tmolteno/TART-3/hardware/lna/img/lna3d.png

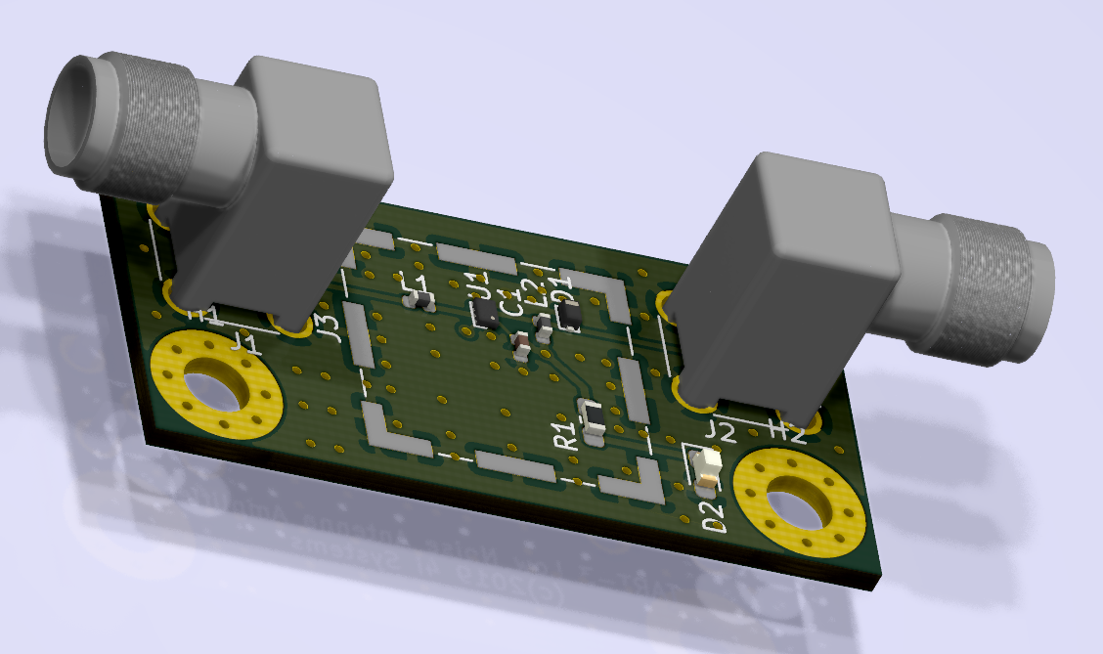
hardware/lna/img/lna3d.png
