tmolteno/TART-3/hardware/lna/img/20190927_lnaAssembled.jpg

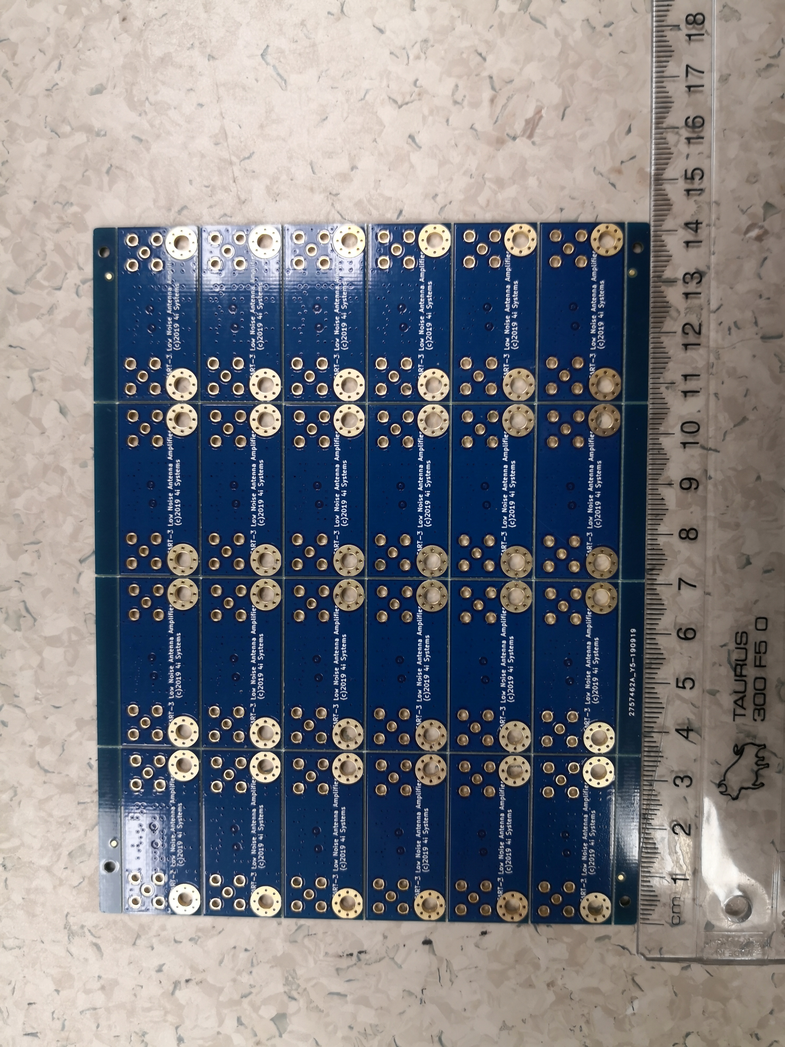
hardware/lna/img/20190927_lnaAssembled.jpg
