tmolteno/TART-3/README.md

# TART-3
The TART radio telescope, Version 3.

TART-3/hardware contains the physical design files.

TART-3/hardware/lna is the design for the seperate low noise front end required when using passive antennas.
