tmolteno/TART-3/hardware/lna/README.md

# TART-3 Low Noise Amplifier

The TART-3 LNA connects the antenna to the radio receiver. 

It is powered by the radio receiver through the coax. The design goal is to get up to 10m of cable.
