tmolteno/TART-3/array/disko_array_opt/README.md

## Array Optimization using the Singular Values of the telescope operator

Author: Tim Molteno

See the jupyter notebook for details.

TODO: 

* Add the ability to start from a JSON file.

The following array reached 16.1:

        Arm 0: [0.224 0.344 0.787 1.292 1.600 1.928 2.864 3.121]
        Arm 120: [0.229 0.897 1.324 2.250 2.585 2.712 3.544 4.174]
        Arm 240: [0.094 0.106 1.001 1.158 1.273 1.575 2.148 3.008]
