tmolteno/TART-3/hardware/lna/img/20191018_lnaScreen.jpg

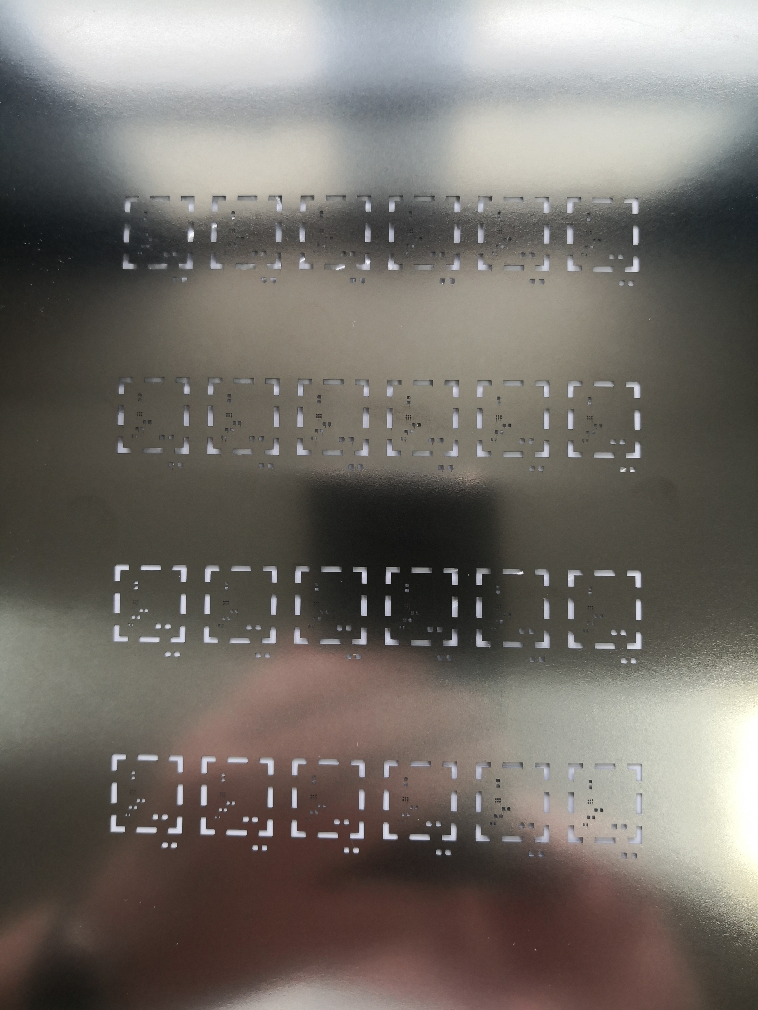
hardware/lna/img/20191018_lnaScreen.jpg
