tmolteno/TART-3/hardware/lna/lna.png

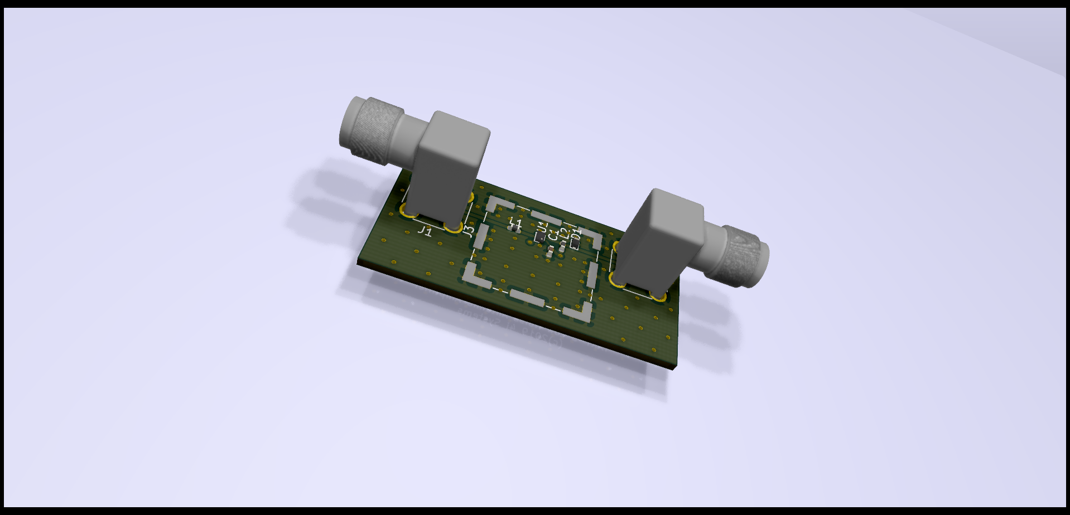
hardware/lna/lna.png
