tmolteno/TART-3/hardware/radio_module/img/radio_module3dBottom.png

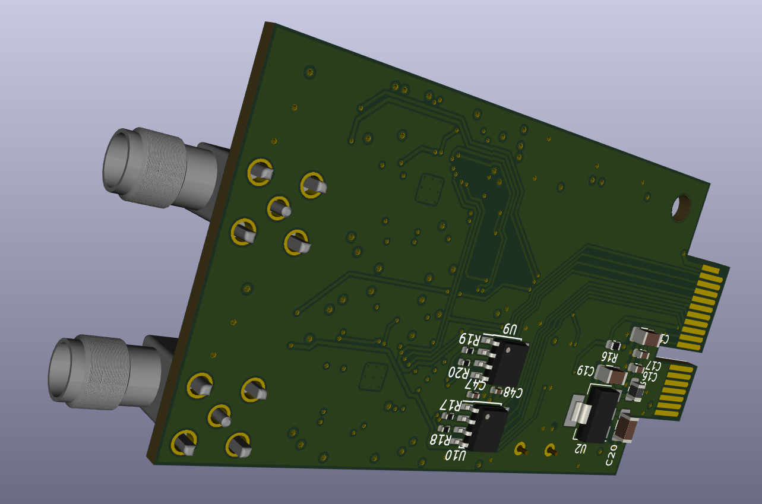
hardware/radio_module/img/radio_module3dBottom.png
