tmolteno/TART-3/hardware/radio_module/img/rf_power-RF Power system.pdf

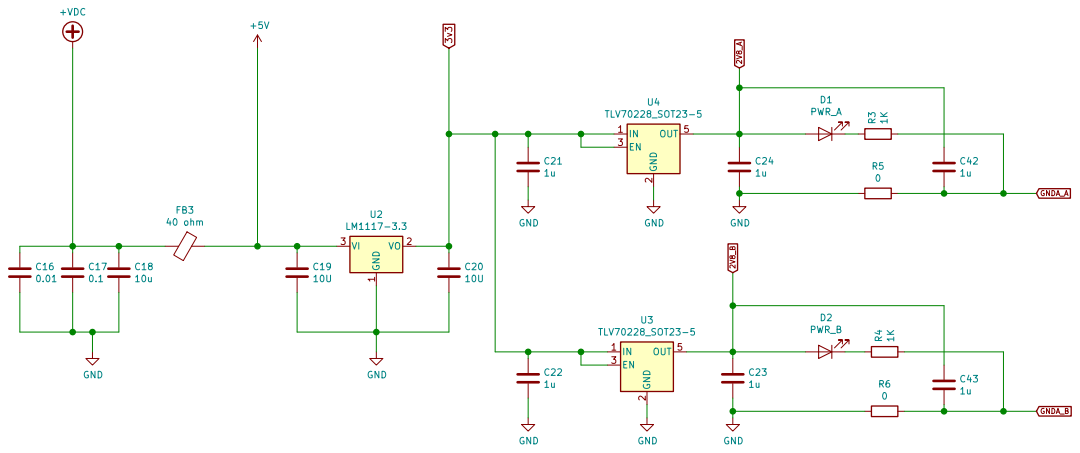
[picture p7: page 1]

Sheet: /RF Power system/ C18
0.1 GND
