tmolteno/TART-3/hardware/lna/img/lna-B_Cu.pdf

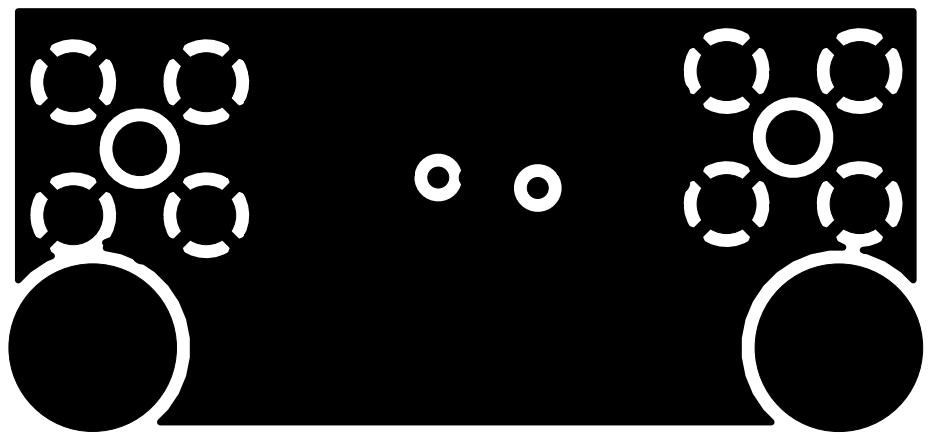
[picture p8: page 1]
