tmolteno/TART-3/hardware/lna/img/lna-F_Cu.pdf

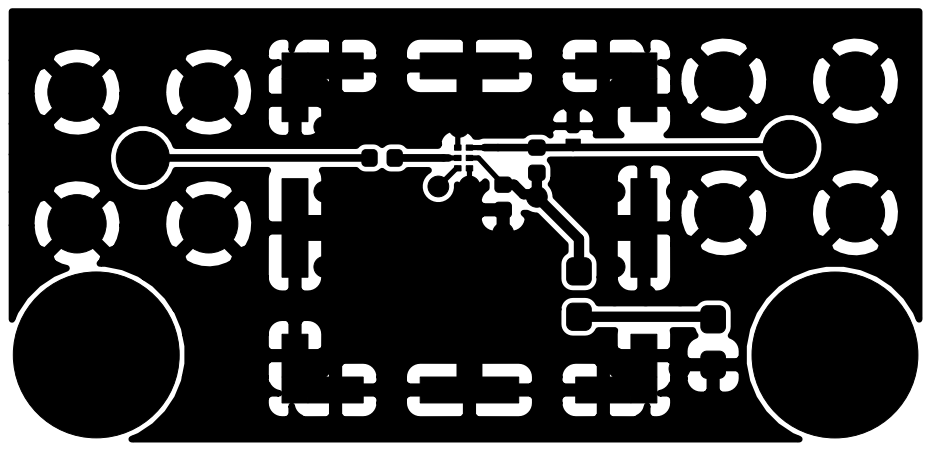
[picture p9: page 1]
