tmolteno/TART-3/hardware/lna/img/lna-F_SilkS.pdf

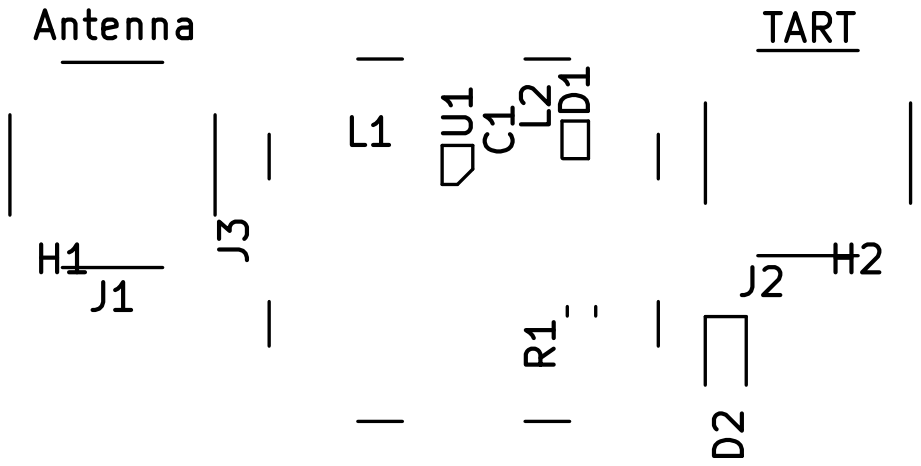
[picture p10: page 1]
