tmolteno/TART-3/hardware/lna/img/lna-In2_Cu.pdf

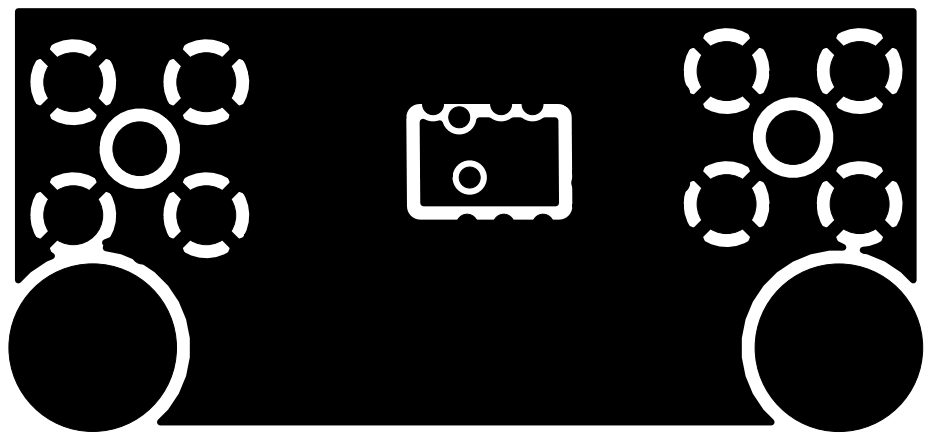
[picture p11: page 1]
