tmolteno/TART-3/hardware/radio_module/img/interface-Interface_A.pdf

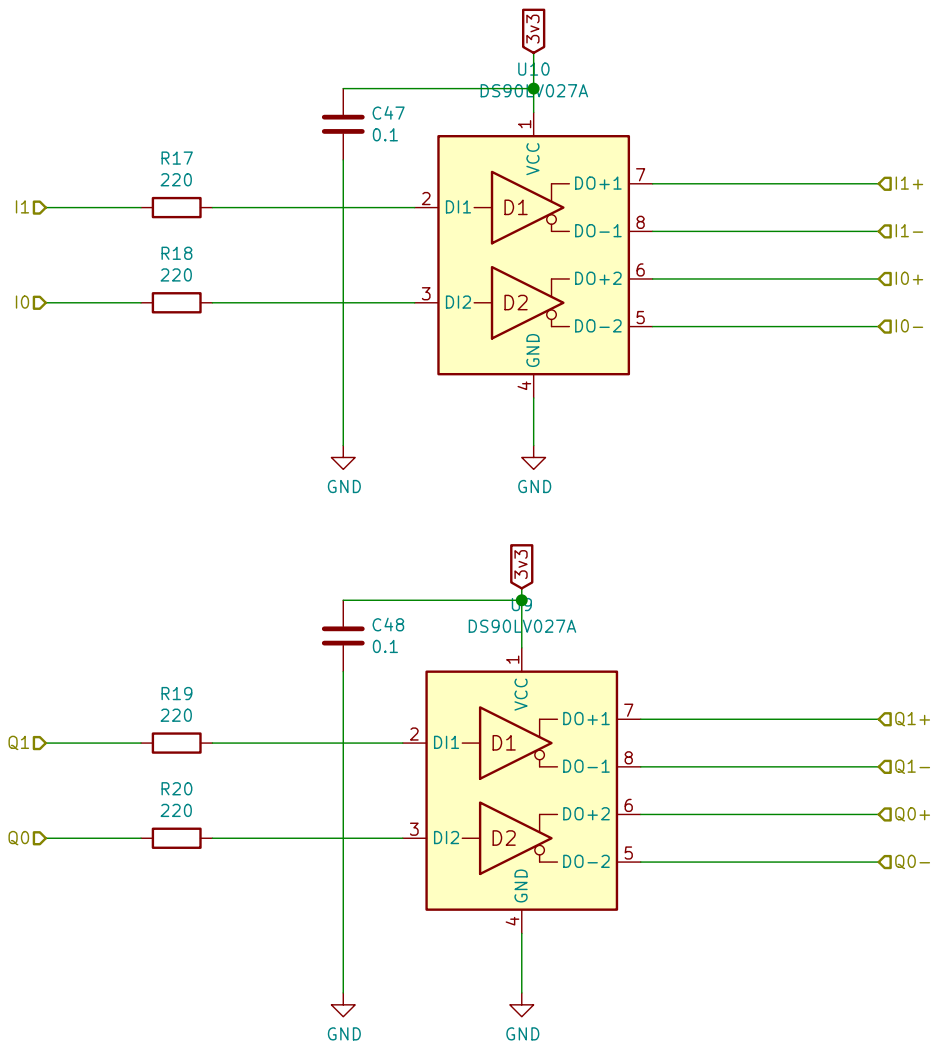
[picture p12: page 1]
