tmolteno/TART-3/hardware/radio_module/img/radio_module.pdf

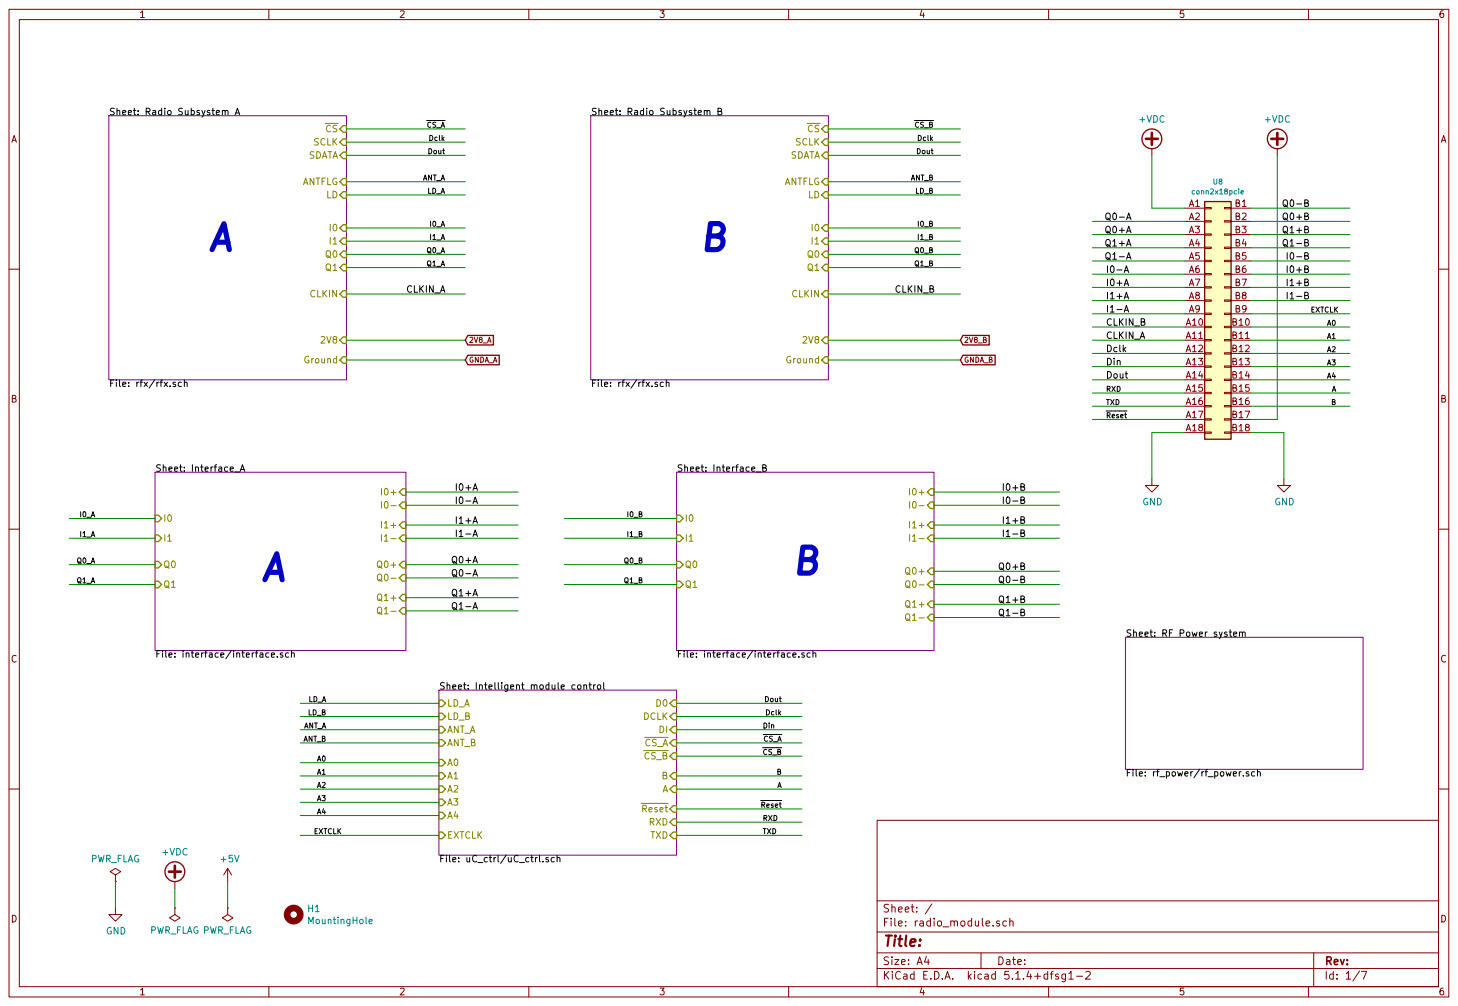
[picture p13: page 1]

File: interface/interface.sch
