tmolteno/TART-3/hardware/radio_module/img/rfx-Radio Subsystem A.pdf

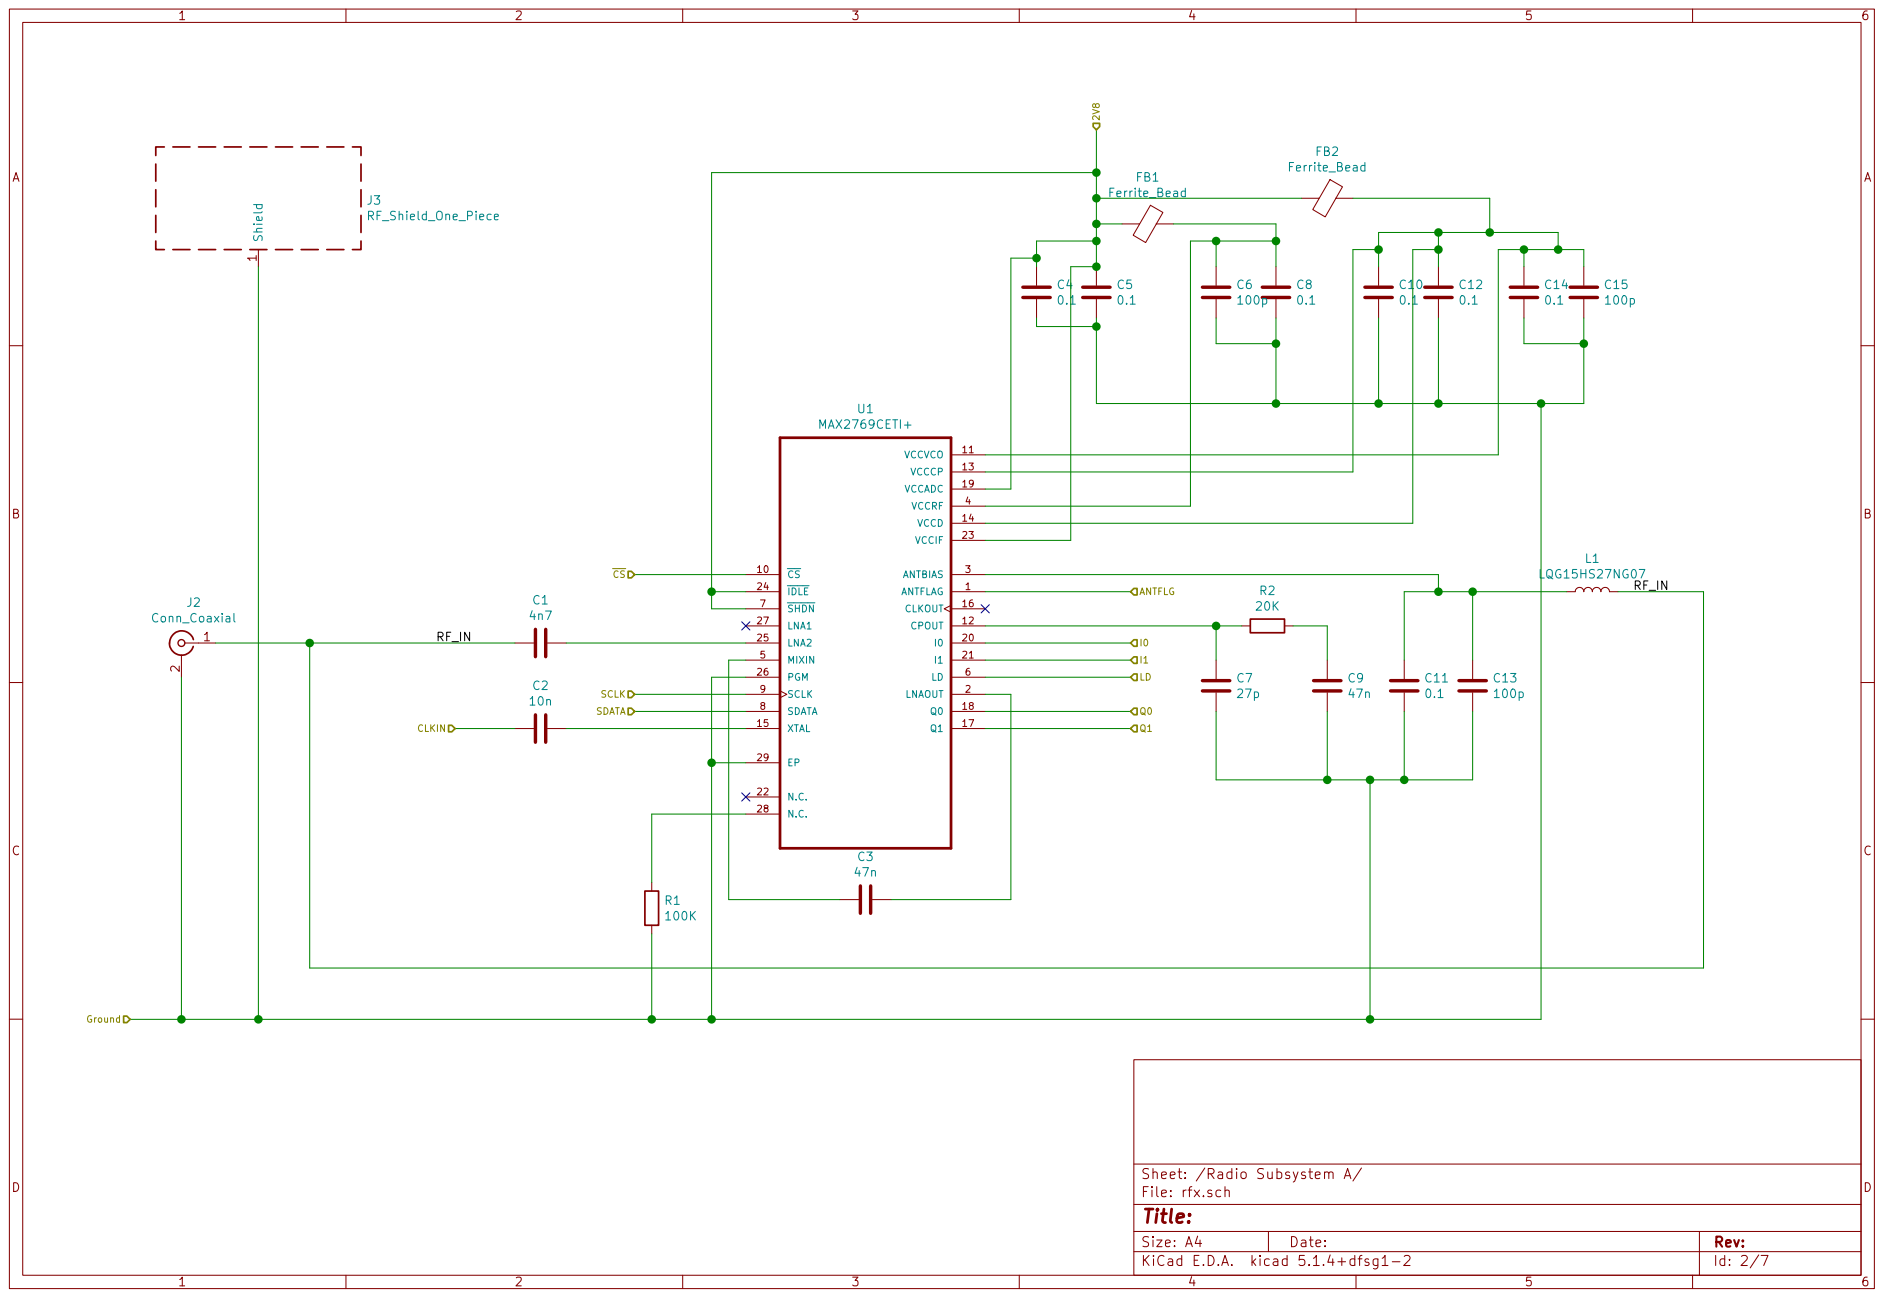
[picture p14: page 1]

Id: 2/7 Title: File: rfx.sch Sheet: /Radio Subsystem A/
