tmolteno/TART-3/hardware/radio_module/img/uC_ctrl-Intelligent module control.pdf

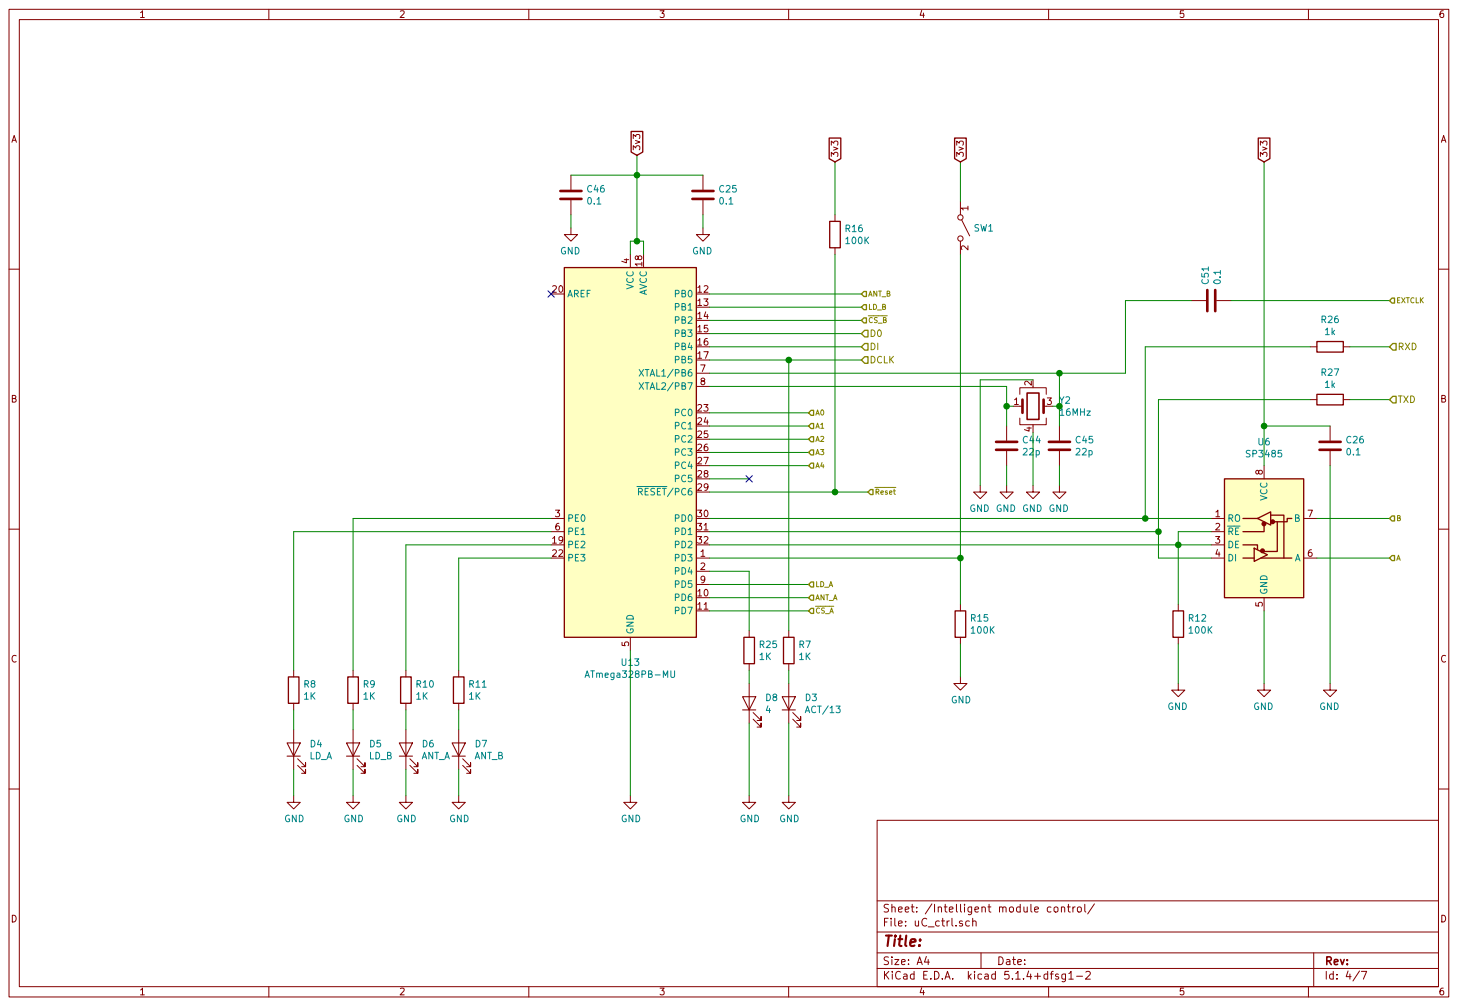
[picture p15: page 1]

Sheet: /Intelligent module control/
File: uC_ctrl.sch
Id: 4/7 Title:
