tmolteno/TART-3/hardware/test/test_fpga_module/test_fpga_module.kicad_pcb

## KiCad design hardware/test/test_fpga_module/test_fpga_module.kicad_pcb (2020-03-13)

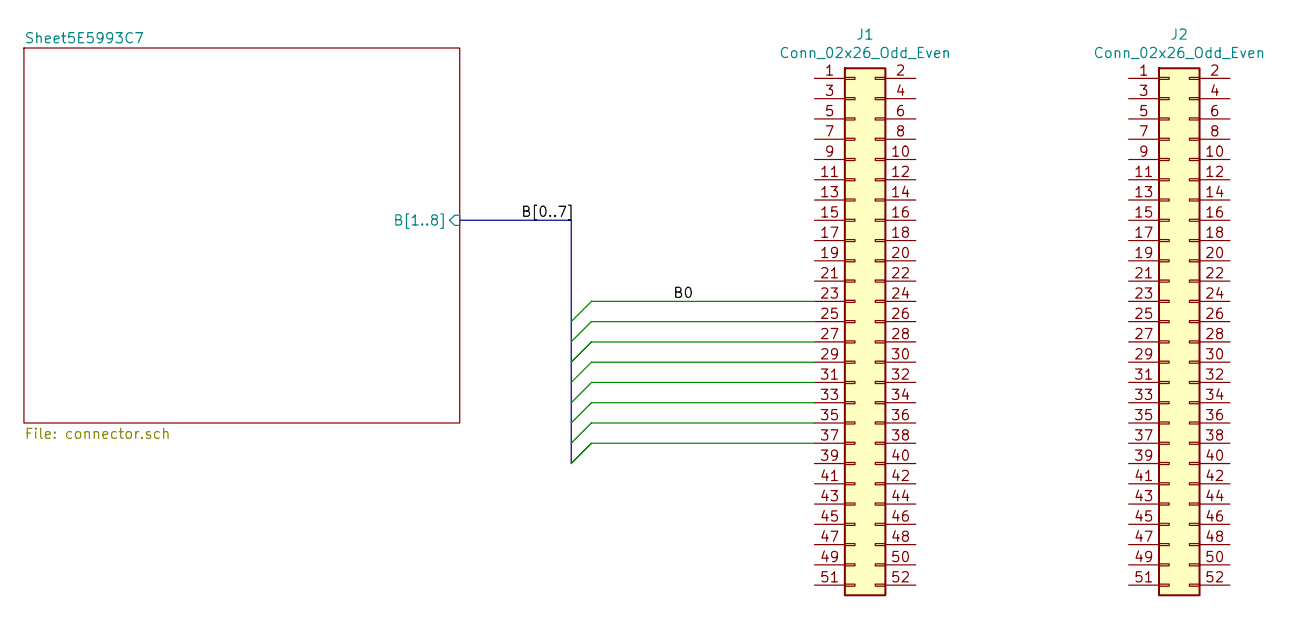
[picture p30: schematic test_fpga_module.sch]

Parts:
J1, J2: Conn_02x26_Odd_Even; Samtec_LSHM-150-xx.x-x-DV-S_2x50-1SH_P0.50mm_Vertical

Connections:
/A1: J1.37; also elsewhere on the board
/A2: J1.35; also elsewhere on the board
/A3: J1.33; also elsewhere on the board
/A4: J1.31; also elsewhere on the board
/A5: J1.29; also elsewhere on the board
/A6: J1.27; also elsewhere on the board
/A7: J1.25; also elsewhere on the board
/A8: J1.23; also elsewhere on the board

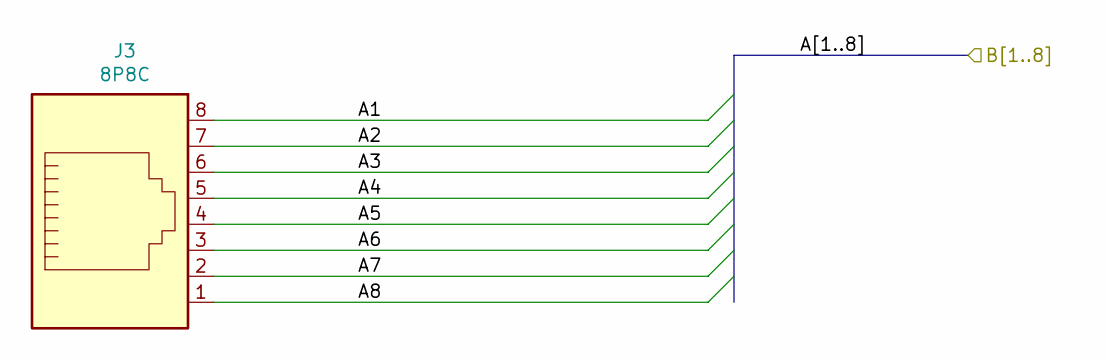
[picture p31: schematic connector.sch]

Parts:
J3: 8P8C; RJ45_Amphenol_54602-x08_Horizontal

Connections:
/A1: J3.8; also elsewhere on the board
/A2: J3.7; also elsewhere on the board
/A3: J3.6; also elsewhere on the board
/A4: J3.5; also elsewhere on the board
/A5: J3.4; also elsewhere on the board
/A6: J3.3; also elsewhere on the board
/A7: J3.2; also elsewhere on the board
/A8: J3.1; also elsewhere on the board

Board: 2 copper layers, 3 parts (0 on the bottom side), 8 nets, no tracks yet.
