tmolteno/TART-3/hardware/radio_dev_board/radioDev.kicad_pcb

## KiCad design hardware/radio_dev_board/radioDev.kicad_pcb (2020-02-21)

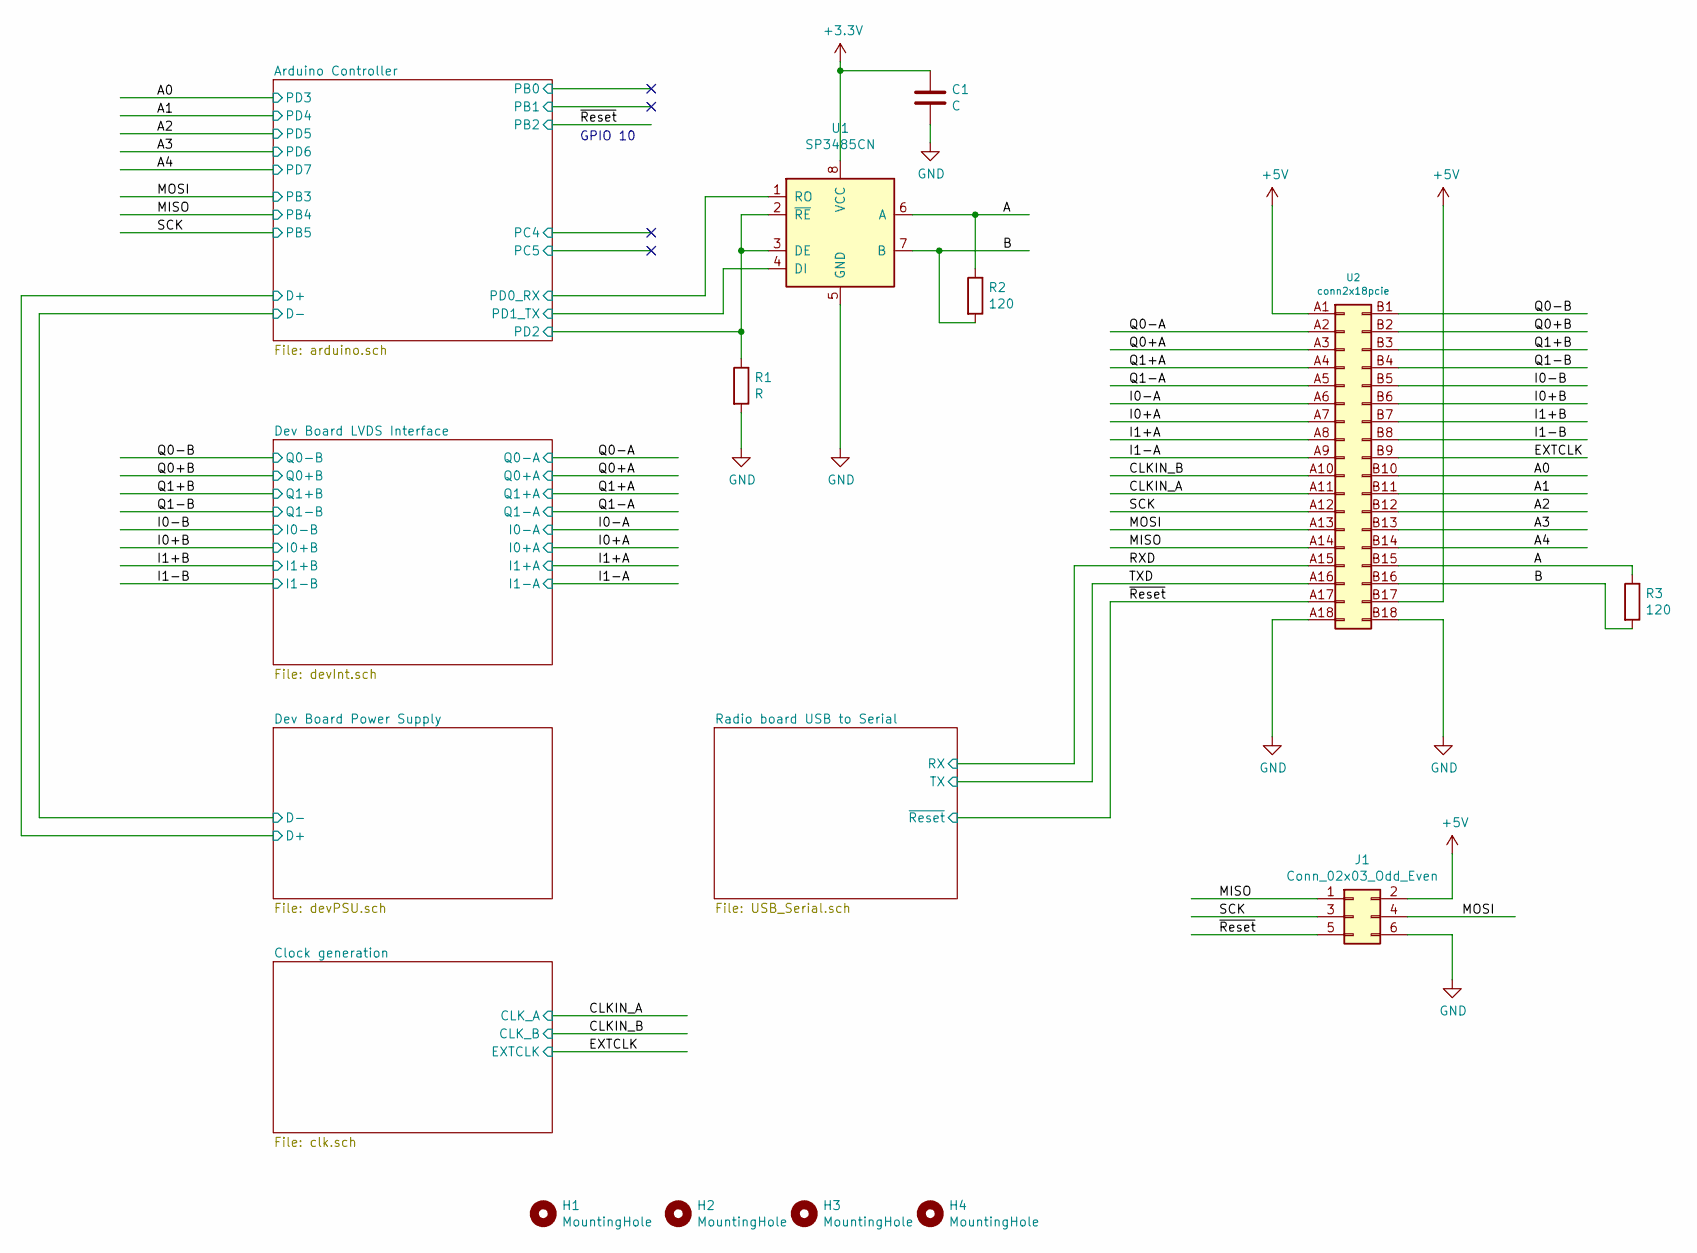
[picture p32: schematic radioDev.sch]

Parts:
C1: C; C_0603_1608Metric_Pad1.05x0.95mm_HandSolder
H1, H2, H3, H4: MountingHole; MountingHole_3.2mm_M3_DIN965
J1: Conn_02x03_Odd_Even; PinHeader_2x03_P2.54mm_Vertical
R1: R; R_0603_1608Metric_Pad1.05x0.95mm_HandSolder
R2, R3: 120; R_0603_1608Metric_Pad1.05x0.95mm_HandSolder
U1: SP3485CN; SOIC-8_3.9x4.9mm_P1.27mm
U2: conn2x18pcie; MOLEX_0877159002

Connections:
+5V: J1.2, U2.A1, U2.B17; also elsewhere on the board
/A: R2.1, R3.1, U1.6 (A), U2.B15
/A0: U2.B10; also elsewhere on the board
/A1: U2.B11; also elsewhere on the board
/A2: U2.B12; also elsewhere on the board
/A3: U2.B13; also elsewhere on the board
/A4: U2.B14; also elsewhere on the board
/Arduino Controller/PD0_RX: U1.1 (RO); also elsewhere on the board
/Arduino Controller/PD1_TX: U1.4 (DI); also elsewhere on the board
/Arduino Controller/PD2: R1.1, U1.2 (~RE~), U1.3 (DE); also elsewhere on the board
/B: R2.2, R3.2, U1.7 (B), U2.B16
/CLKIN_A: U2.A10, U2.A11, U2.B9; also elsewhere on the board
/I0+A: U2.A7; also elsewhere on the board
/I0+B: U2.B6; also elsewhere on the board
/I0-A: U2.A6; also elsewhere on the board
/I0-B: U2.B5; also elsewhere on the board
/I1+A: U2.A8; also elsewhere on the board
/I1+B: U2.B7; also elsewhere on the board
/I1-A: U2.A9; also elsewhere on the board
/I1-B: U2.B8; also elsewhere on the board
/MISO: J1.1, U2.A14; also elsewhere on the board
/MOSI: J1.4, U2.A13; also elsewhere on the board
/Q0+A: U2.A3; also elsewhere on the board
/Q0+B: U2.B2; also elsewhere on the board
/Q0-A: U2.A2; also elsewhere on the board
/Q0-B: U2.B1; also elsewhere on the board
/Q1+A: U2.A4; also elsewhere on the board
/Q1+B: U2.B3; also elsewhere on the board
/Q1-A: U2.A5; also elsewhere on the board
/Q1-B: U2.B4; also elsewhere on the board
/RXD: U2.A15; also elsewhere on the board
/SCK: J1.3, U2.A12; also elsewhere on the board
/TXD: U2.A16; also elsewhere on the board
/~Reset: J1.5, U2.A17; also elsewhere on the board
GND: C1.2, J1.6, R1.2, U1.5 (GND), U2.A18, U2.B18; also elsewhere on the board

Notes on the sheet:
GPIO 10
