tmolteno/TART-3/hardware/radio_dev_board/radioDev.kicad_pcb

## KiCad design hardware/radio_dev_board/radioDev.kicad_pcb (continued)

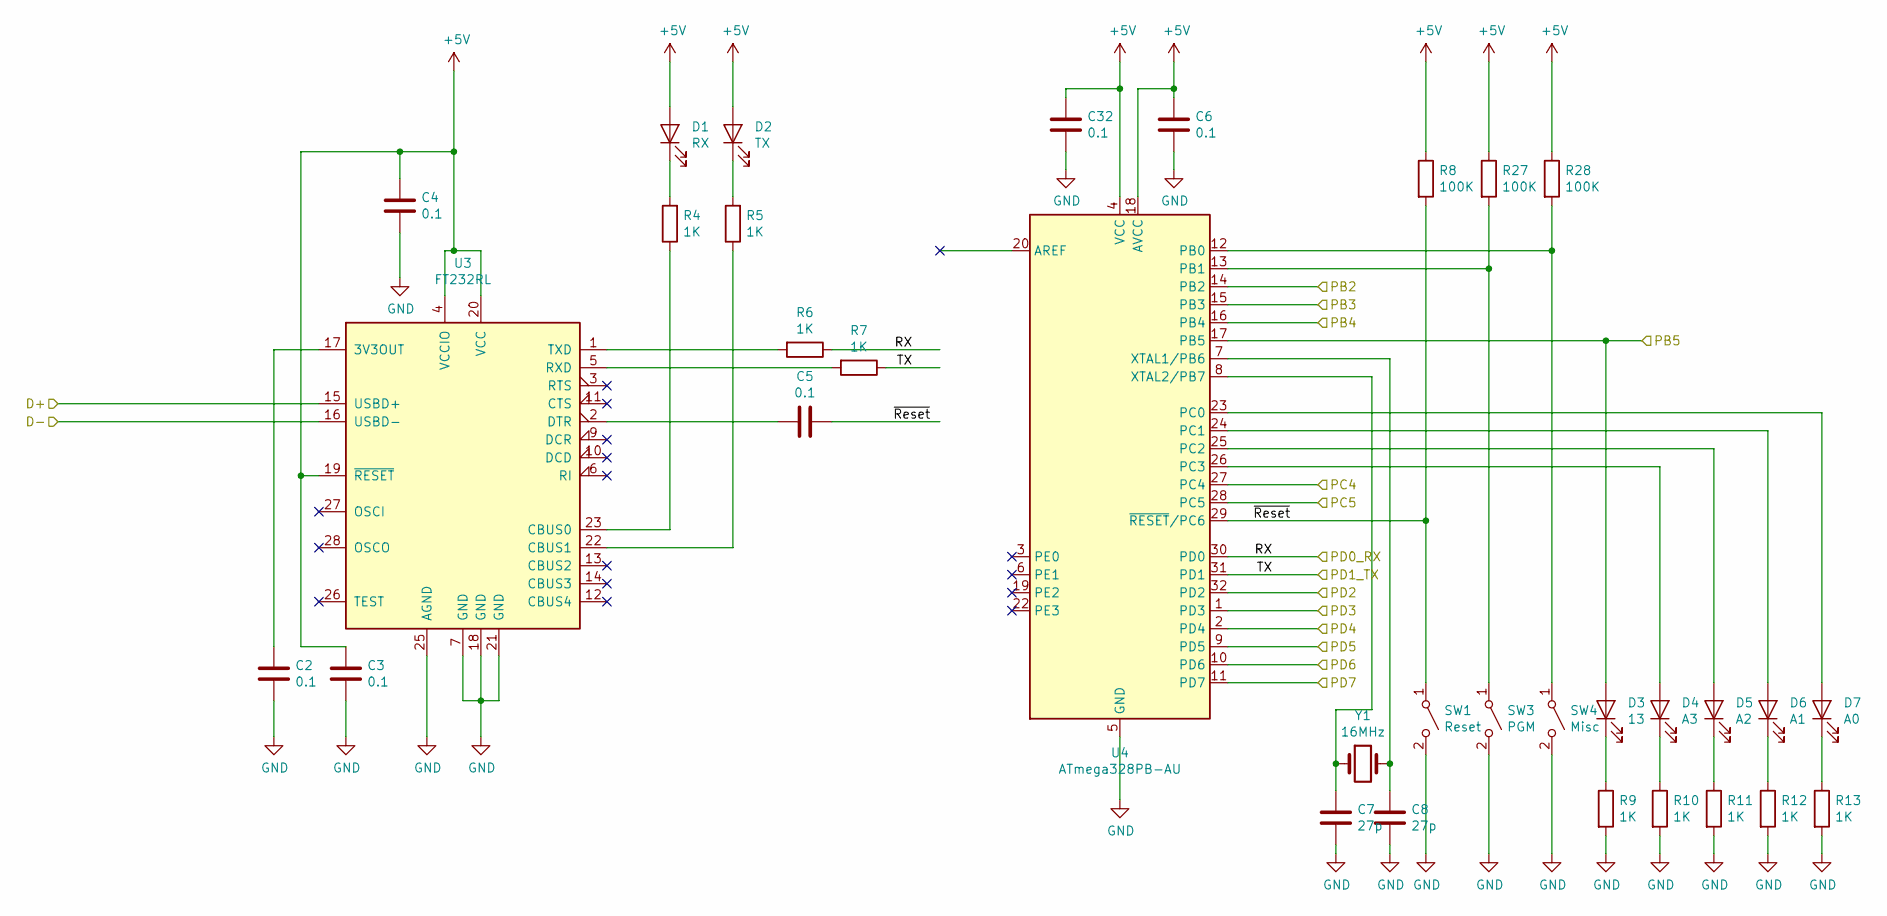
[picture p33: schematic arduino.sch]

Parts:
C2, C3, C4, C5, C6, C32: 0.1; C_0603_1608Metric_Pad1.05x0.95mm_HandSolder
C7, C8: 27p; C_0603_1608Metric_Pad1.05x0.95mm_HandSolder
D1: RX; LED_0603_1608Metric_Pad1.05x0.95mm_HandSolder
D2: TX; LED_0603_1608Metric_Pad1.05x0.95mm_HandSolder
D3: 13; LED_0603_1608Metric_Pad1.05x0.95mm_HandSolder
D4: A3; LED_0603_1608Metric_Pad1.05x0.95mm_HandSolder
D5: A2; LED_0603_1608Metric_Pad1.05x0.95mm_HandSolder
D6: A1; LED_0603_1608Metric_Pad1.05x0.95mm_HandSolder
D7: A0; LED_0603_1608Metric_Pad1.05x0.95mm_HandSolder
R4, R5, R6, R7, R9, R10, R11, R12, R13: 1K; R_0603_1608Metric_Pad1.05x0.95mm_HandSolder
R8, R27, R28: 100K; R_0603_1608Metric_Pad1.05x0.95mm_HandSolder
SW1: Reset; SW_SPST_PTS645
SW3: PGM; SW_SPST_PTS645
SW4: Misc; SW_SPST_PTS645
U3: FT232RL; SSOP-28_5.3x10.2mm_P0.65mm
U4: ATmega328PB-AU; TQFP-32_7x7mm_P0.8mm
Y1: 16MHz; Crystal_HC49-4H_Vertical

Connections:
+5V: C3.1, C4.1, C6.1, C32.1, D1.2 (A), D2.2 (A), R8.1, R27.1, R28.1, U3.4 (VCCIO), U3.19 (~RESET~), U3.20 (VCC), U4.4 (VCC), U4.18 (AVCC); also elsewhere on the board
/A0: U4.1 (PD3); also elsewhere on the board
/A1: U4.2 (PD4); also elsewhere on the board
/A2: U4.9 (PD5); also elsewhere on the board
/A3: U4.10 (PD6); also elsewhere on the board
/A4: U4.11 (PD7); also elsewhere on the board
/Arduino Controller/D+: U3.15 (USBD+); also elsewhere on the board
/Arduino Controller/D-: U3.16 (USBD-); also elsewhere on the board
/Arduino Controller/PD0_RX: R6.1, U4.30 (PD0); also elsewhere on the board
/Arduino Controller/PD1_TX: R7.1, U4.31 (PD1); also elsewhere on the board
/Arduino Controller/PD2: U4.32 (PD2); also elsewhere on the board
/Arduino Controller/~Reset: C5.1, R8.2, SW1.1 (A), U4.29 (~RESET~/PC6)
/MISO: U4.16 (PB4); also elsewhere on the board
/MOSI: U4.15 (PB3); also elsewhere on the board
/SCK: D3.2 (A), U4.17 (PB5); also elsewhere on the board
/~Reset: U4.14 (PB2); also elsewhere on the board
GND: C2.2, C3.2, C4.2, C6.2, C7.2, C8.2, C32.2, R9.2, R10.2, R11.2, R12.2, R13.2, SW1.2 (B), SW3.2 (B), SW4.2 (B), U3.7 (GND), U3.18 (GND), U3.21 (GND), U3.25 (AGND), U4.5 (GND), U4.21 (GND); also elsewhere on the board
unnamed: C2.1, U3.17 (3V3OUT)
unnamed: C5.2, U3.2 (DTR)
unnamed: C7.1, U4.8 (XTAL2/PB7), Y1.1
unnamed: C8.1, U4.7 (XTAL1/PB6), Y1.2
unnamed: D1.1 (K), R4.2
unnamed: D2.1 (K), R5.2
unnamed: D3.1 (K), R9.1
unnamed: D4.1 (K), R10.1
unnamed: D4.2 (A), U4.26 (PC3)
unnamed: D5.1 (K), R11.1
unnamed: D5.2 (A), U4.25 (PC2)
unnamed: D6.1 (K), R12.1
unnamed: D6.2 (A), U4.24 (PC1)
unnamed: D7.1 (K), R13.1
unnamed: D7.2 (A), U4.23 (PC0)
unnamed: R4.1, U3.23 (CBUS0)
unnamed: R5.1, U3.22 (CBUS1)
unnamed: R6.2, U3.1 (TXD)
unnamed: R7.2, U3.5 (RXD)
unnamed: R27.2, SW3.1 (A), U4.13 (PB1)
unnamed: R28.2, SW4.1 (A), U4.12 (PB0)

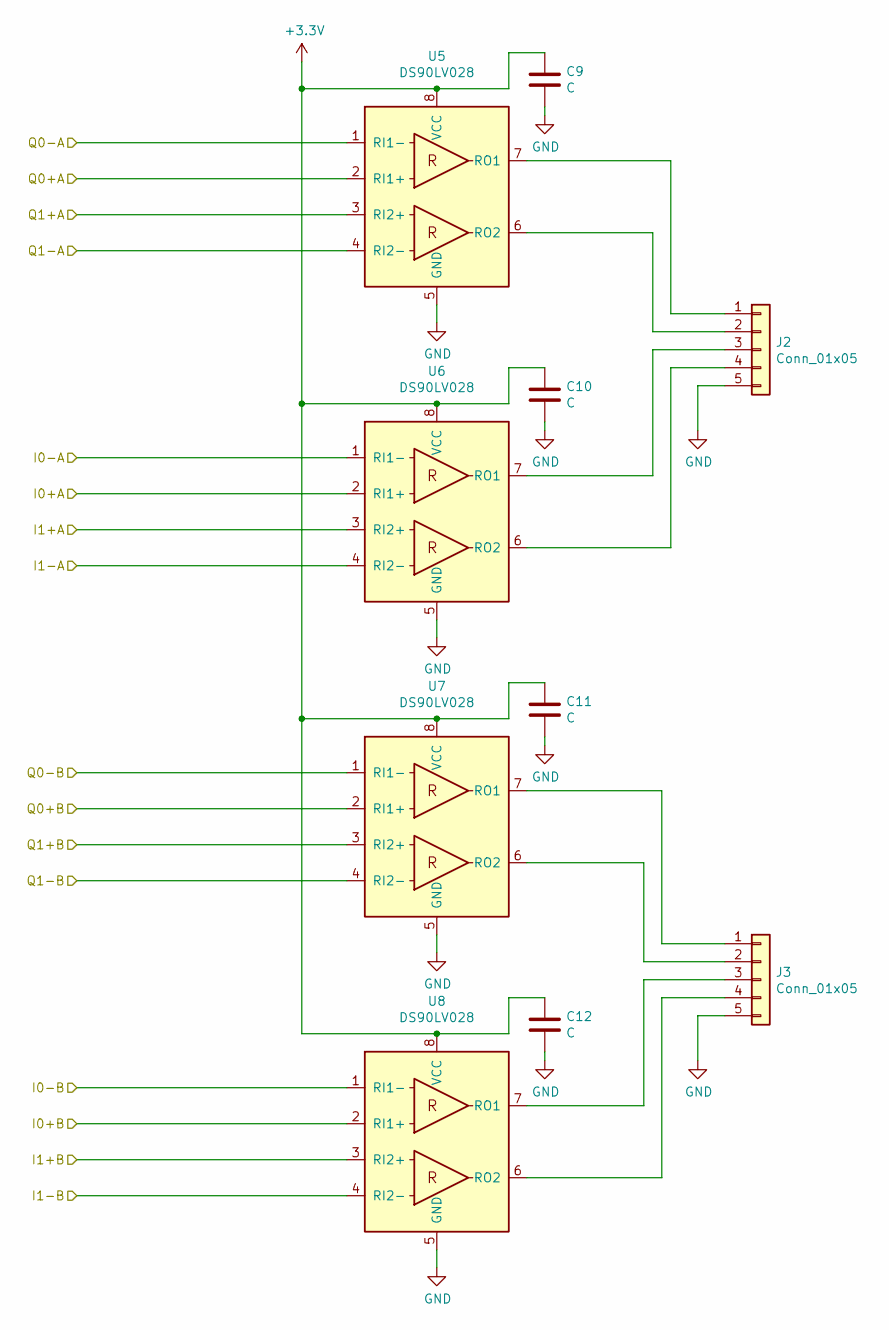
[picture p34: schematic devInt.sch]

Parts:
C9, C10, C11, C12: C; C_0603_1608Metric_Pad1.05x0.95mm_HandSolder
J2, J3: Conn_01x05; PinHeader_1x05_P2.54mm_Vertical
U5, U6, U7, U8: DS90LV028; SSO-8_6.8x5.9mm_P1.27mm_Clearance7mm

Connections:
/I0+A: U6.2 (RI1+); also elsewhere on the board
/I0+B: U8.2 (RI1+); also elsewhere on the board
/I0-A: U6.1 (RI1-); also elsewhere on the board
/I0-B: U8.1 (RI1-); also elsewhere on the board
/I1+A: U6.3 (RI2+); also elsewhere on the board
/I1+B: U8.3 (RI2+); also elsewhere on the board
/I1-A: U6.4 (RI2-); also elsewhere on the board
/I1-B: U8.4 (RI2-); also elsewhere on the board
/Q0+A: U5.2 (RI1+); also elsewhere on the board
/Q0+B: U7.2 (RI1+); also elsewhere on the board
/Q0-A: U5.1 (RI1-); also elsewhere on the board
/Q0-B: U7.1 (RI1-); also elsewhere on the board
/Q1+A: U5.3 (RI2+); also elsewhere on the board
/Q1+B: U7.3 (RI2+); also elsewhere on the board
/Q1-A: U5.4 (RI2-); also elsewhere on the board
/Q1-B: U7.4 (RI2-); also elsewhere on the board
GND: C9.2, C10.2, C11.2, C12.2, J2.5, J3.5, U5.5 (GND), U6.5 (GND), U7.5 (GND), U8.5 (GND); also elsewhere on the board
unnamed: J2.1, U5.7 (RO1)
unnamed: J2.2, U5.6 (RO2)
unnamed: J2.3, U6.7 (RO1)
unnamed: J2.4, U6.6 (RO2)
unnamed: J3.1, U7.7 (RO1)
unnamed: J3.2, U7.6 (RO2)
unnamed: J3.3, U8.7 (RO1)
unnamed: J3.4, U8.6 (RO2)

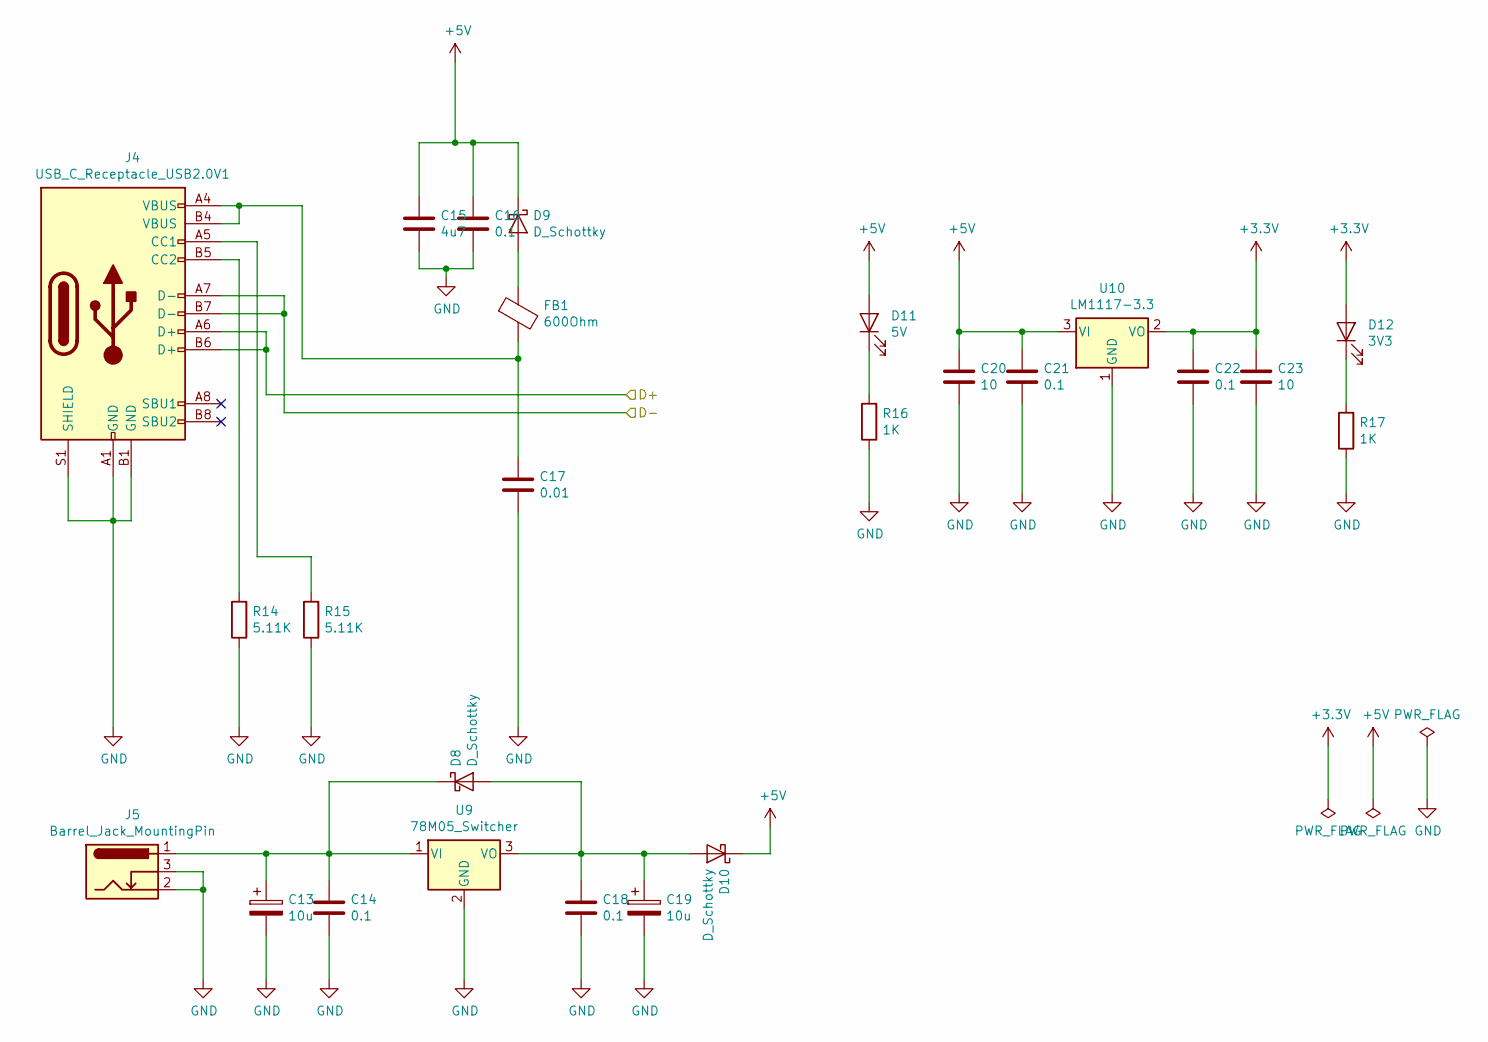
[picture p35: schematic devPSU.sch]

Parts:
C13, C19: 10u; CP_Radial_D12.5mm_P5.00mm
C14, C16, C18, C21, C22: 0.1; C_0603_1608Metric_Pad1.05x0.95mm_HandSolder
C15: 4u7; C_0805_2012Metric_Pad1.15x1.40mm_HandSolder
C17: 0.01; C_0603_1608Metric_Pad1.05x0.95mm_HandSolder
C20, C23: 10; C_1210_3225Metric_Pad1.42x2.65mm_HandSolder
D8, D9, D10: D_Schottky; D_SOD-123F
D11: 5V; LED_0603_1608Metric_Pad1.05x0.95mm_HandSolder
D12: 3V3; LED_0603_1608Metric_Pad1.05x0.95mm_HandSolder
FB1: 600Ohm; L_0603_1608Metric_Pad1.05x0.95mm_HandSolder
J4: USB_C_Receptacle_USB2.0V1; TYPE-C-31-M-12
J5: Barrel_Jack_MountingPin; BarrelJack_Wuerth_6941xx301002
R14, R15: 5.11K; R_0603_1608Metric_Pad1.05x0.95mm_HandSolder
R16, R17: 1K; R_0603_1608Metric_Pad1.05x0.95mm_HandSolder
U9: 78M05_Switcher; TO-220-3_Vertical
U10: LM1117-3.3; SOT-223-3_TabPin2

Connections:
+5V: C15.1, C16.1, C20.1, C21.1, D9.1 (K), D10.1 (K), D11.2 (A), U10.3 (VI); also elsewhere on the board
/Arduino Controller/D+: J4.A6 (D+), J4.B6 (D+); also elsewhere on the board
/Arduino Controller/D-: J4.A7 (D-), J4.B7 (D-); also elsewhere on the board
GND: C13.2, C14.2, C15.2, C16.2, C17.2, C18.2, C19.2, C20.2, C21.2, C22.2, C23.2, J4.A1 (GND), J4.B1 (GND), J4.S1 (SHIELD), J5.2, J5.3, R14.1, R15.1, R16.1, R17.1, U9.2 (GND), U10.1 (GND); also elsewhere on the board
unnamed: C13.1, C14.1, D8.1 (K), J5.1, U9.1 (VI)
unnamed: C17.1, FB1.2, J4.A4 (VBUS), J4.B4 (VBUS)
unnamed: C18.1, C19.1, D8.2 (A), D10.2 (A), U9.3 (VO)
unnamed: D9.2 (A), FB1.1
unnamed: D11.1 (K), R16.2
unnamed: D12.1 (K), R17.2
unnamed: J4.A5 (CC1), R15.2
unnamed: J4.B5 (CC2), R14.2

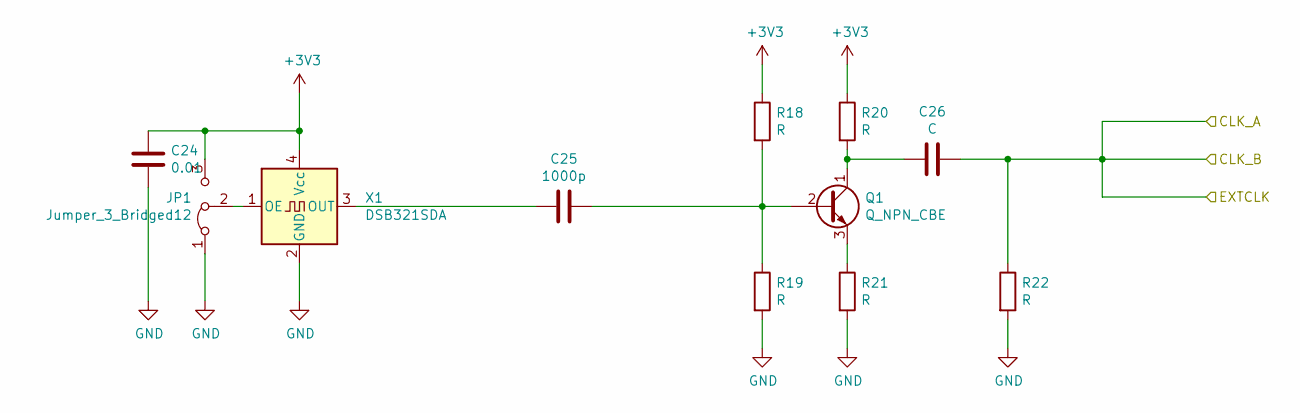
[picture p36: schematic clk.sch]

Parts:
C24: 0.01; C_0603_1608Metric_Pad1.05x0.95mm_HandSolder
C25: 1000p; C_0603_1608Metric_Pad1.05x0.95mm_HandSolder
C26: C; C_0603_1608Metric_Pad1.05x0.95mm_HandSolder
JP1: Jumper_3_Bridged12; SolderJumper-3_P1.3mm_Bridged2Bar12_Pad1.0x1.5mm
Q1: Q_NPN_CBE; SOT-23
R18, R19, R20, R21, R22: R; R_0603_1608Metric_Pad1.05x0.95mm_HandSolder
X1: DSB321SDA; Oscillator_SMD_SeikoEpson_SG210-4Pin_2.5x2.0mm

Connections:
/CLKIN_A: C26.1, R22.1; also elsewhere on the board
GND: C24.2, JP1.1 (A), R19.2, R21.2, R22.2, X1.2 (GND); also elsewhere on the board
unnamed: C25.1, Q1.2 (B), R18.2, R19.1
unnamed: C25.2, X1.3 (OUT)
unnamed: C26.2, Q1.1 (C), R20.2
unnamed: JP1.2 (C), X1.1 (OE)
unnamed: Q1.3 (E), R21.1

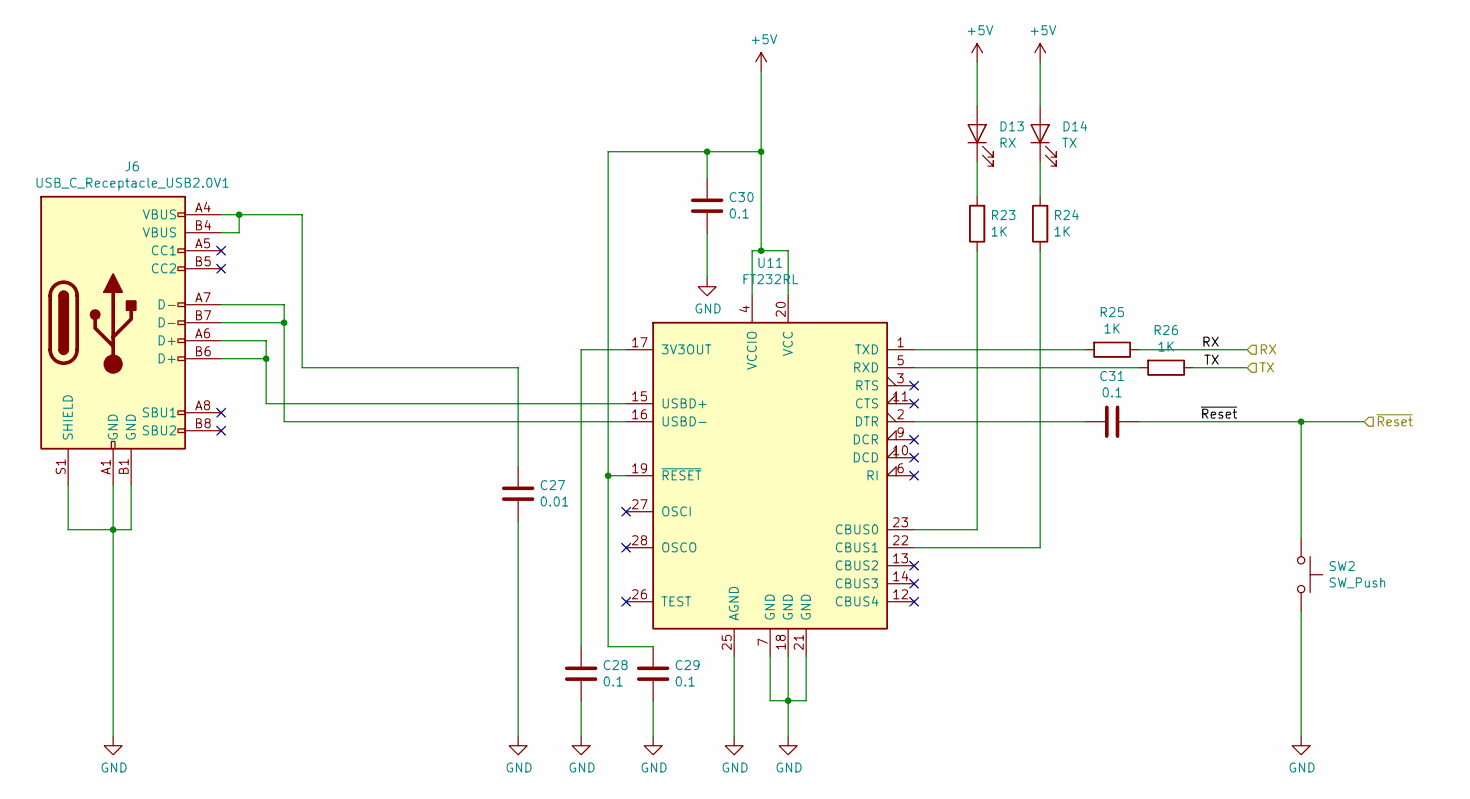
[picture p37: schematic USB_Serial.sch]

Parts:
C27: 0.01; C_0603_1608Metric_Pad1.05x0.95mm_HandSolder
C28, C29, C30, C31: 0.1; C_0603_1608Metric_Pad1.05x0.95mm_HandSolder
D13: RX; LED_0603_1608Metric_Pad1.05x0.95mm_HandSolder
D14: TX; LED_0603_1608Metric_Pad1.05x0.95mm_HandSolder
J6: USB_C_Receptacle_USB2.0V1; TYPE-C-31-M-12
R23, R24, R25, R26: 1K; R_0603_1608Metric_Pad1.05x0.95mm_HandSolder
SW2: SW_Push; SW_SPST_PTS645
U11: FT232RL; SSOP-28_5.3x10.2mm_P0.65mm

Connections:
+5V: C29.1, C30.1, D13.2 (A), D14.2 (A), U11.4 (VCCIO), U11.19 (~RESET~), U11.20 (VCC); also elsewhere on the board
/RXD: R25.1; also elsewhere on the board
/TXD: R26.1; also elsewhere on the board
/~Reset: C31.1, SW2.1; also elsewhere on the board
GND: C27.2, C28.2, C29.2, C30.2, J6.A1 (GND), J6.B1 (GND), J6.S1 (SHIELD), SW2.2, U11.7 (GND), U11.18 (GND), U11.21 (GND), U11.25 (AGND); also elsewhere on the board
unnamed: C27.1, J6.A4 (VBUS), J6.B4 (VBUS)
unnamed: C28.1, U11.17 (3V3OUT)
unnamed: C31.2, U11.2 (DTR)
unnamed: D13.1 (K), R23.2
unnamed: D14.1 (K), R24.2
unnamed: J6.A6 (D+), J6.B6 (D+), U11.15 (USBD+)
unnamed: J6.A7 (D-), J6.B7 (D-), U11.16 (USBD-)
unnamed: R23.1, U11.23 (CBUS0)
unnamed: R24.1, U11.22 (CBUS1)
unnamed: R25.2, U11.1 (TXD)
unnamed: R26.2, U11.5 (RXD)

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
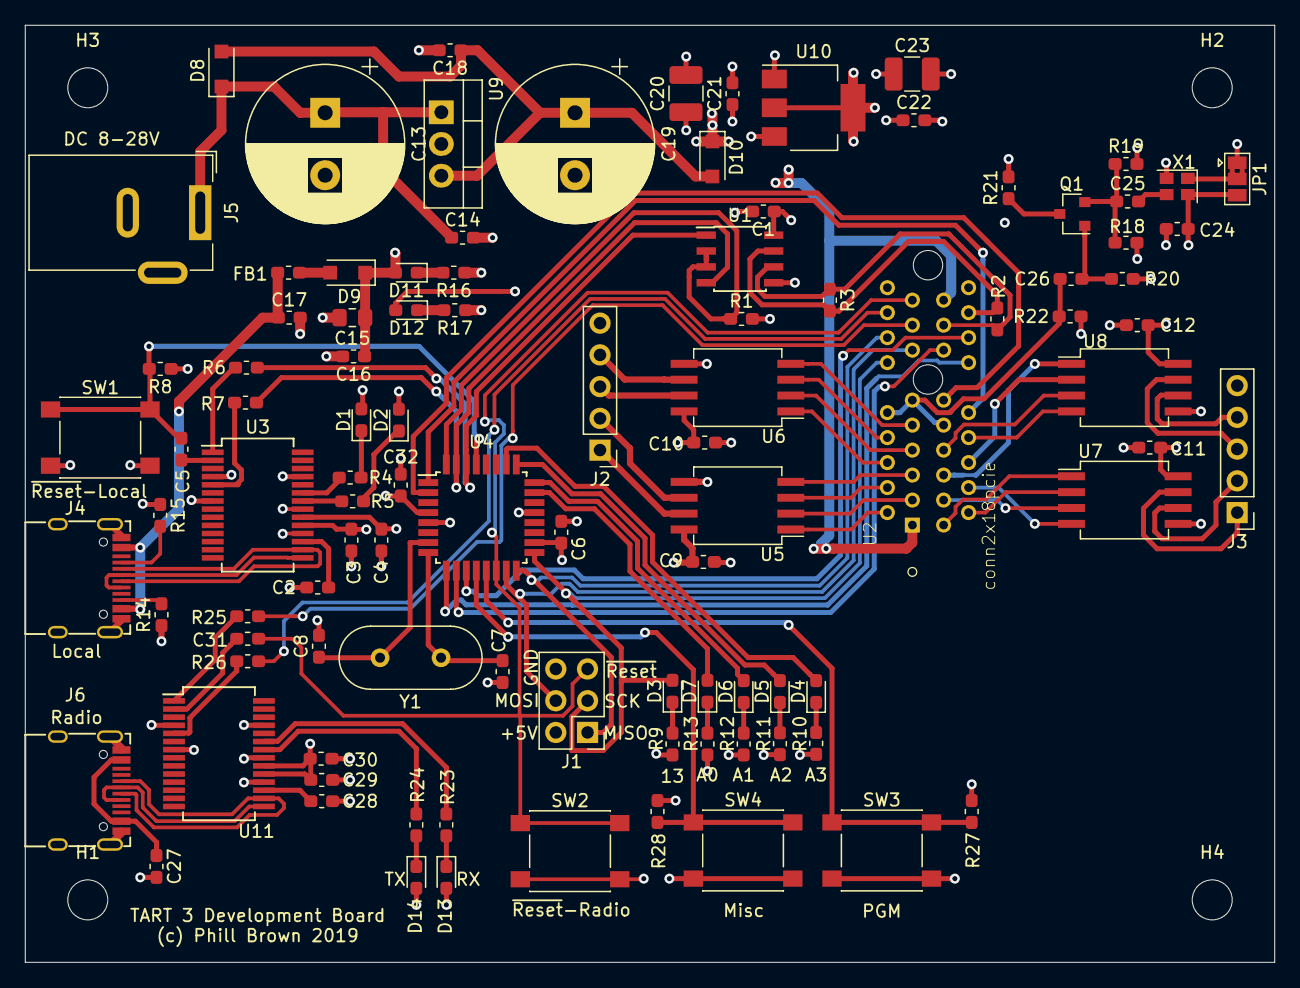
[picture p38: board radioDev.kicad_pcb from above]

Board: 4 copper layers, 100.0 x 75.0 mm, 104 parts (0 on the bottom side), 92 nets.
