tmolteno/TART-3/hardware/lna/lna.kicad_pcb

## KiCad design hardware/lna/lna.kicad_pcb (2019-12-02)

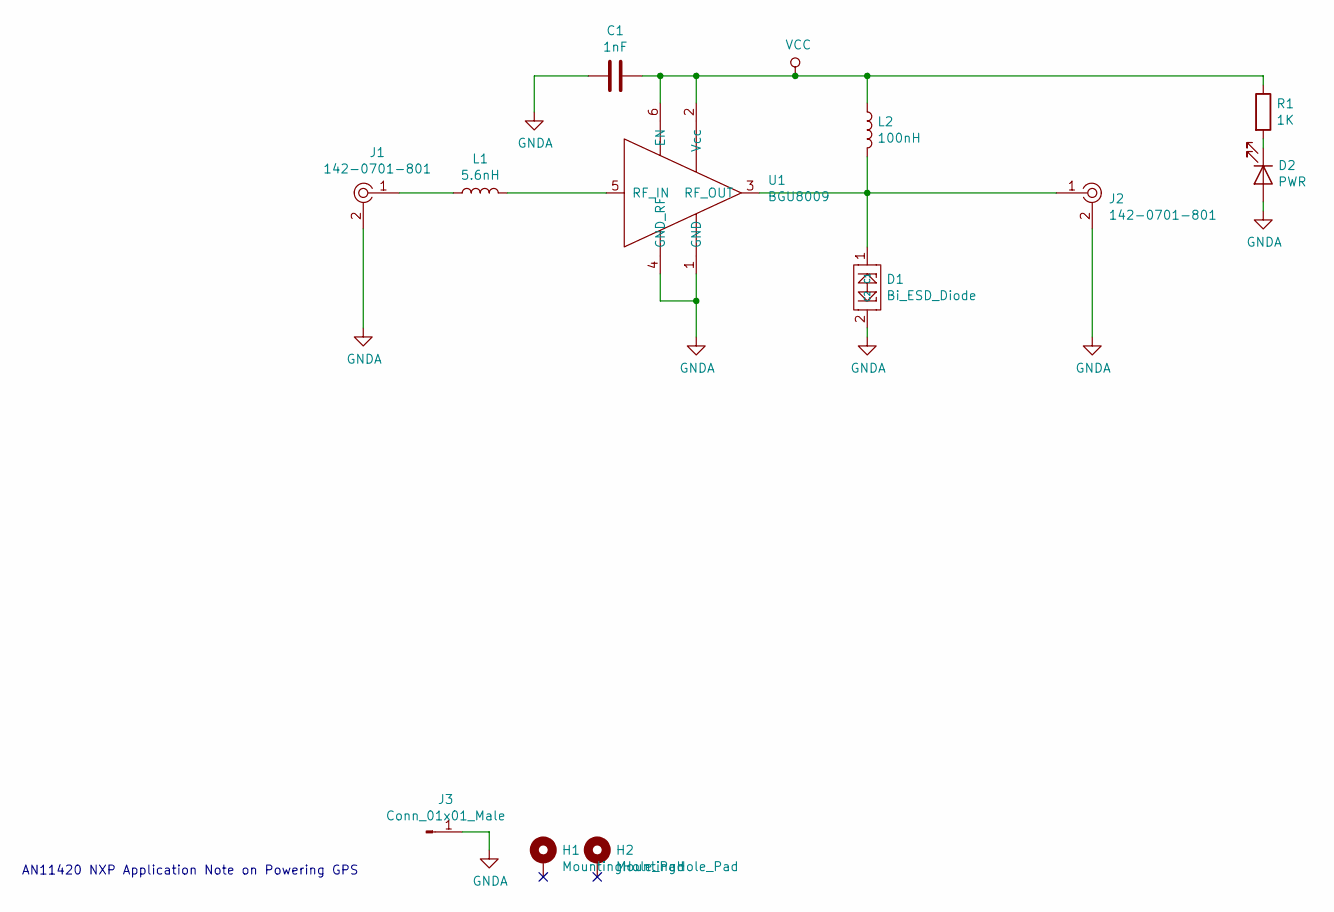
[picture p45: schematic lna.sch, Seperate LNA]

Parts:
C1: 1nF; C_0402_1005Metric
D1: Bi_ESD_Diode; SOIC-2
D2: PWR; LED_0603_1608Metric_Pad1.05x0.95mm_HandSolder
H1, H2: MountingHole_Pad; MountingHole_3.2mm_M3_Pad_Via
J1, J2: 142-0701-801; SMA_Amphenol_132134_Vertical; MPN 142-0701-801; Digi-Key_PN J502-ND
J3: Conn_01x01_Male; Laird_Technologies_BMI-S-101_13.66x12.70mm
L1: 5.6nH; L_0402_1005Metric
L2: 100nH; L_0402_1005Metric
R1: 1K; R_0603_1608Metric_Pad1.05x0.95mm_HandSolder
U1: BGU8009; XSON-NXP-6

Connections:
GNDA: C1.1, D1.2 (C2), D2.2 (A), J1.2, J2.2, J3.1, U1.1 (GND), U1.4 (GND_RF)
unnamed: D1.1 (C1), J2.1, L2.2, U1.3 (RF_OUT)
unnamed: D2.1 (K), R1.2
unnamed: J1.1, L1.1
unnamed: L1.2, U1.5 (RF_IN)
VCC: C1.2, L2.1, R1.1, U1.2 (Vcc), U1.6 (EN)

Notes on the sheet:
AN11420 NXP Application Note on Powering GPS

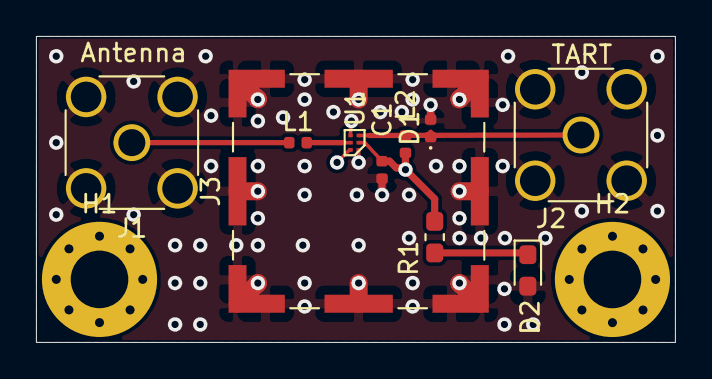
[picture p46: board lna.kicad_pcb from above]

Board: 4 copper layers, 35.5 x 17.0 mm, 12 parts (0 on the bottom side), 6 nets.
