tmolteno/TART-3/(commit log)

2019-09-01 Added the LNA
    [lna.kicad_pcb, lna.sch]
2019-09-04 completed schematic and laid out PCB
    [lna.kicad_pcb, lna.sch]
2019-09-05 changed connectors and added 3d stuff
    [lna.kicad_pcb, lna.sch]
2019-09-05 Add shield and mounting holes
    [lna.kicad_pcb, lna.sch]
2019-10-03 Preliminary radio module schematic
    [FPGA_Module.sch, base_module.kicad_pcb, base_module.sch, hub_module.kicad_pcb, hub_module.sch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]
2019-10-11 Initial complete layout of the radio board
    [interface.sch, radio_module.kicad_pcb, radio_module.sch, rf_power.sch, rfx.sch, uC_ctrl.sch]
2019-10-18 Update radio board, change crystal and get 3d up to date
    [interface.sch, lna.sch, radio_module.kicad_pcb, radio_module.sch, uC_ctrl.sch]
2019-10-23 Add Arduino programming lines. Tidy up layout
    [interface.sch, radio_module.kicad_pcb, radio_module.sch, rfx.sch, uC_ctrl.sch]
2019-10-30 Altered board to have components on one side
    [radio_module.kicad_pcb]
2019-11-07 Update radio module add extclk, new atmega package, new crystal
    [lna.sch, radio_module.kicad_pcb, radio_module.sch, rfx.sch, uC_ctrl.sch]
2019-12-02 added development board
    [arduino.sch, clk.sch, devInt.sch, devPSU.sch, lna.kicad_pcb, lnaBare.sch, radioDev.kicad_pcb, radioDev.sch]
2019-12-11 added radio USB serial channel. Update board layout
    [USB_Serial.sch, arduino.sch, clk.sch, devInt.sch, devPSU.sch, radioDev.kicad_pcb]
2019-12-12 added program and misc buttons. Finish layout
    [USB_Serial.sch, arduino.sch, clk.sch, devInt.sch, devPSU.sch, radioDev.kicad_pcb, radioDev.sch]
2020-02-21 radio hub board started
    [USB_Serial.sch, arduino.sch, clk.sch, connector.sch, connector1.sch, devInt.sch, devPSU.sch, hub_module.kicad_pcb]
2020-03-13 busses added
    [FPGA_Module.sch, FPGA_ModuleB.sch, Wiring1.sch, Wiring2.sch, Wiring3.sch, clock.sch, connector.sch, hub_module.kicad_pcb]
2020-06-09 Avoid recalculation. Refactor to allow better calculation of other antenna arrays
2020-06-10 Improved progress printing
