tmolteno/TART-3/(notices)

Notices in the files:
hardware/lna/lna.kicad_pcb:
(c)2019 4i Systems
